benorose/XunFengzhandui/docs/机械组/README.md

# 迅风战队_机械组学习历程

机械组的核心任务是负责一辆小车从建模、打印到装配的全流程工作，确保每个环节衔接顺畅，最终实现小车的完整功能。

## 一、培训学习阶段

### （一）9月27日：机械组第一次通识培训

本次培训围绕小车的组成及相关核心概念展开，具体学习内容如下：

#### 1. 车的组成（地面车型）

| 车型 | 组成部分 | 具体说明 |
| --- | --- | --- |
| 步兵、英雄 | 底盘 | 包含麦轮、舵机、全向轮，是小车移动的基础部件 |
| | 供弹系统 | 需减小云台惯量，并与底盘形成耦合，保障供弹稳定性 |
| | 云台 | 发射系统有两种选择：气动发射系统、摩擦轮发射系统 |
| 工程 | 机械臂 | 由大臂、scara（选择性装配关节机械臂）、副手三部分构成，用于完成特定作业任务 |
| | 底盘 | - |
| | 机架 | 采用铝合金或碳板拼接而成，作用类似“骨头”，为各模块提供稳定支撑 |

#### 2. 核心力学概念

- **强度（屈服强度）**：指材料抵抗塑性形变与断裂的能力，具体是指材料发生明显塑性形变时所对应的应力值。
- **刚度**：材料抵抗弹性形变的能力，刚度越高，材料在受力时越不容易发生弹性变形。
- **拖裂**：一种特殊的断裂形式，材料在没有发生塑性形变的情况下直接断裂。
- **抗拉强度**：材料在被拉断前所能承受的最大应力值，是衡量材料抵抗拉伸破坏能力的重要指标。
- **应力**：单位面积上所承受的压力，是表征材料受力状态的关键参数。
  - **正应力**：方向垂直于材料截面的应力。
  - **切应力**：方向平行于材料截面的应力。
- **应变**：描述物体受力后变形程度的物理量，反映了材料形变的大小。

#### 3. 标准件

重点学习了紧固件类标准件，包括螺丝、螺母、铆钉、垫片，这些零件是小车装配过程中用于连接固定各部件的关键元件。

#### 4. 过往项目参考

- 2025年：无人机云台设计、英雄六摩擦云台设计、英雄中心供弹部分研发
- 2026年：大臂工程模块研发（追赶项目）
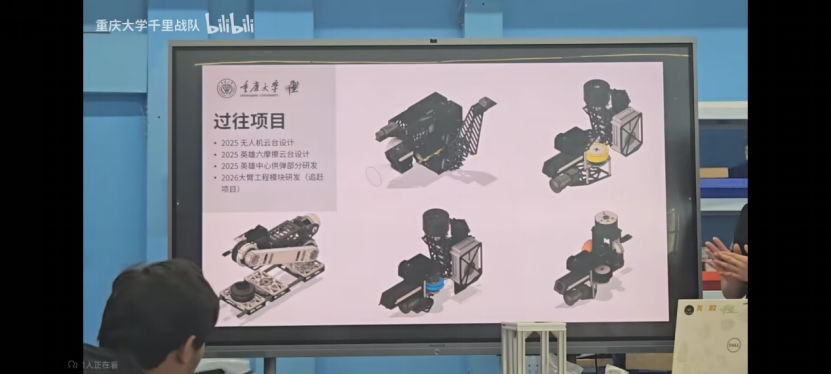
[picture p1: docs/机械组/README.assets/image-20251026011003347.png]
- 

### （二）10月1日 - 10月8日：线上软件学习

自主学习B站Fusion 360基础建模教程，掌握软件基本操作，为后续小车建模工作打下基础。

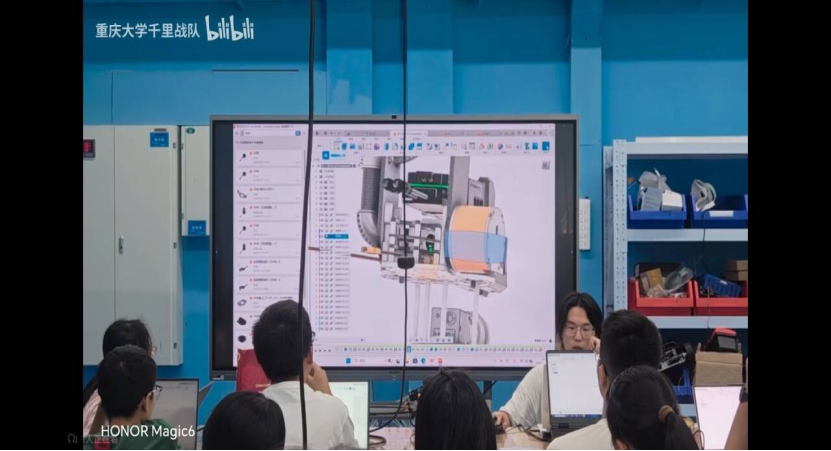
[picture p2: docs/机械组/README.assets/image-20251026011023373.png]


### （三）10月12日：机械组第二次Fusion 360使用教学培训

#### 1. 核心建模流程

1. 选取合适的平面作为草图绘制基准面；
2. 在选定平面上绘制零件的二维草图；
3. 基于二维草图通过拉伸、旋转等操作生成三维实体（特征）。

#### 2. 关键技能学习

学习零件之间的装配与约束方法，掌握如何通过添加约束（如重合、平行、垂直等）确保零件在装配体中位置准确、运动协调。

#### 3. 实践操作
跟随教学视频完成麦克纳姆轮（麦轮）的建模，建模涉及的零件及结构如下：
- 基础部件：支持架（2个）、中轴（1个）
- 功能部件：滚轮（8个，分别为滚轮1 - 8）
- 紧固件：长螺丝（8个，分别为长螺丝1 - 8）、防松螺母（5个，分别为防松螺母1 - 5）

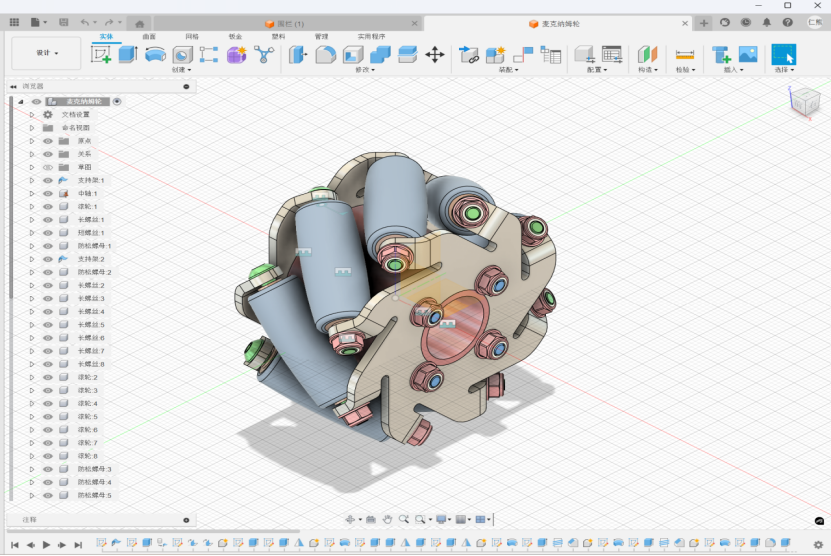
[picture p3: docs/机械组/README.assets/image-20251026011112353.png]


## 二、设计研发阶段

### （一）10月9日：确定小车设计方案
队伍初步明确小车设计方向，采用滚筒作为小球收集装置，通过滚筒的自动运转实现小球的高效收集。

### （二）10月15日 - 10月22日：零件建模与问题解决

#### 1. 舵机与底板连接问题解决
- **问题**：在建模过程中，遇到舵机与底板之间连接方式不明确的问题，需设计专用零件实现两者的固定约束。
- **解决方法**：设计“舵机固定”零件，该零件可有效衔接舵机与底板，确保两者相对位置固定，满足使用需求。
- **最终效果**：舵机与底板通过“舵机固定”零件实现稳定连接，具体效果如图所示：
舵机固定零件连接效果

#### 2. 滚筒拆分建模
为简化建模流程、提高模型精度，将滚筒设计拆分为四个部分分别建模，各部分具体信息如下：
- **连接杆**：滚筒的连接支撑部件，模型如图所示：
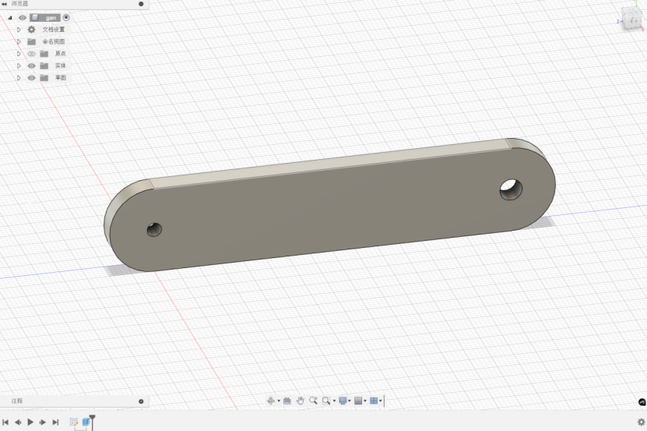
[picture p4: docs/机械组/README.assets/image-20251026011256394.png]
  

- **轴心杆**：滚筒的核心旋转部件，模型如图所示：

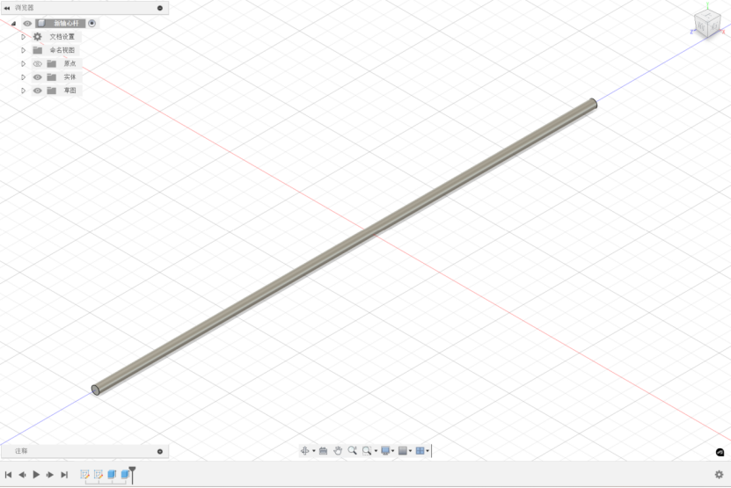
[picture p5: docs/机械组/README.assets/image-20251026011329607.png]
- 

- **圆盘**：滚筒的辅助结构部件，模型如图所示：

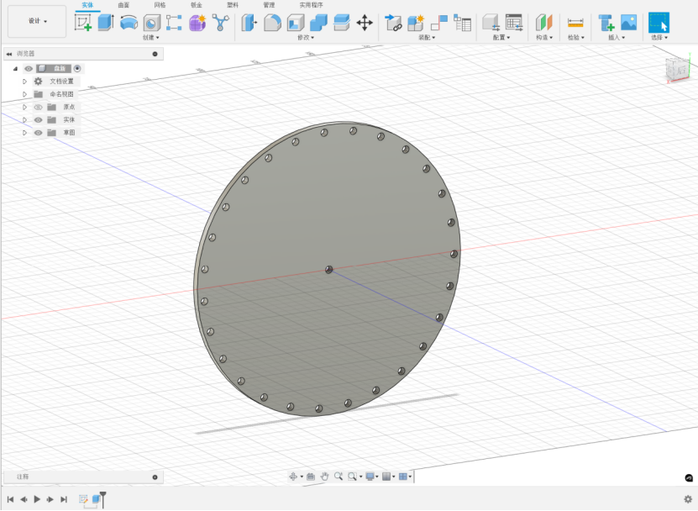
[picture p6: docs/机械组/README.assets/image-20251026011349457.png]
- 

- **固定盖**：用于固定滚筒各部件的零件，模型如图所示：
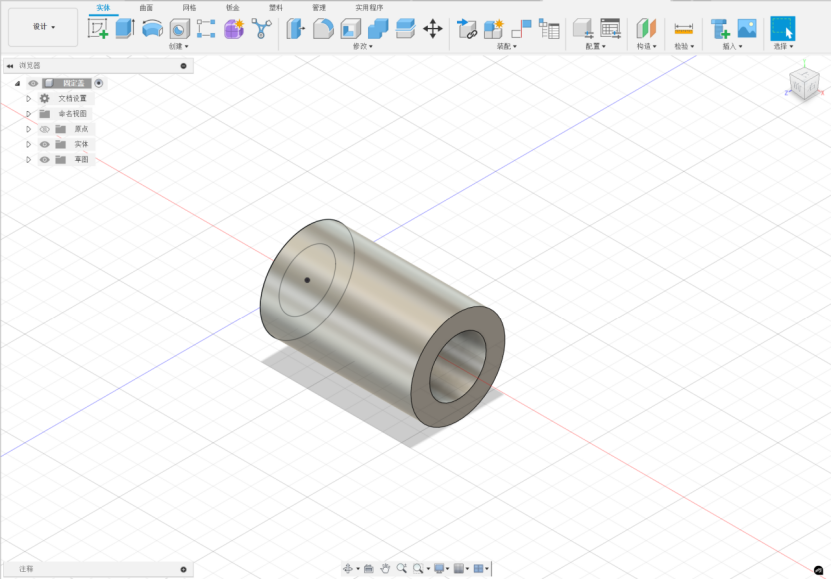
[picture p7: docs/机械组/README.assets/image-20251026011402899.png]
  

- **完整效果：**

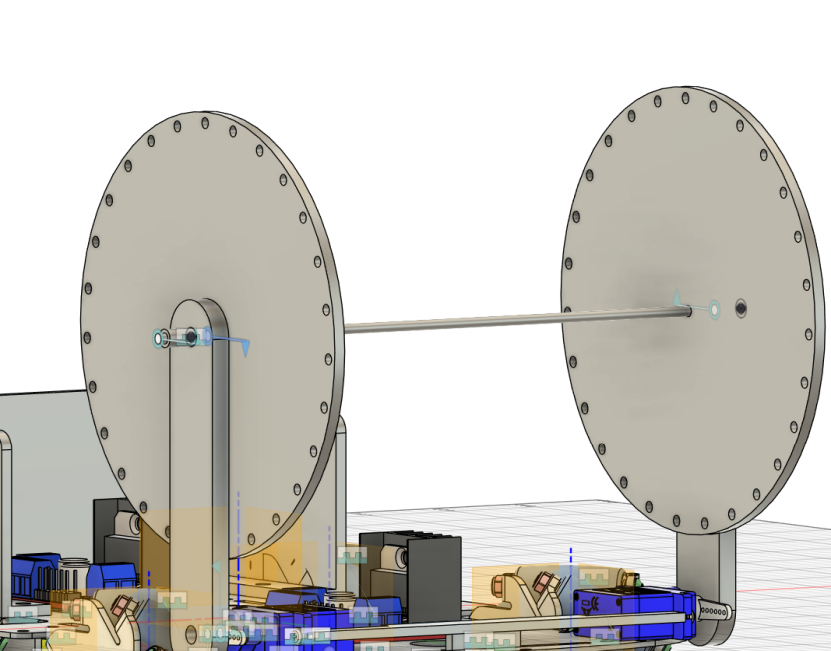
[picture p8: docs/机械组/README.assets/image-20251026011540131.png]
  

#### 3. 围栏设计
为实现小球的有效收集，设计围栏结构，用于引导和限制小球运动轨迹，确保小球能顺利进入滚筒收集范围，围栏模型如图所示：
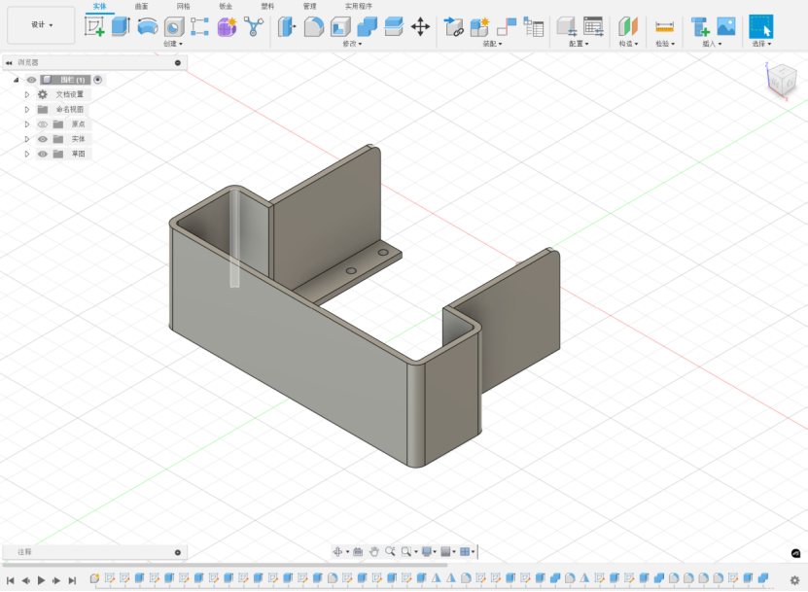
[picture p9: docs/机械组/README.assets/image-20251026011450980.png]


#### 4. 整车装配建模
完成各零件建模后，进行小车整体的连接装配建模，最终得到小车完整装配模型，模型包含金属底盘、黄马达、L298N电机驱动、麦克纳姆轮、舵机、舵机固定件、滚筒各部件、围栏等所有核心部件，具体如图所示：
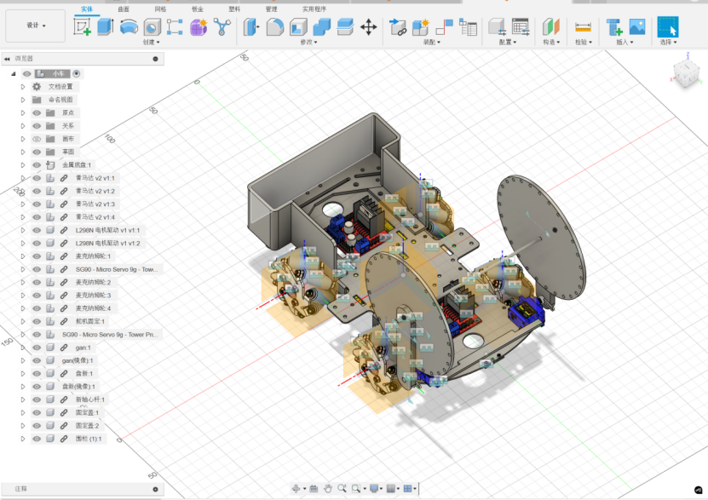
[picture p10: docs/机械组/README.assets/image-20251026011506100.png]


通过联接检测验证，该装配模型能够实现各部件的正常转动，且满足刚性约束要求，符合设计预期。

## 三、实物制作阶段

### （一）10月24日：3D打印培训与零件打印
参与线下3D打印培训，掌握3D打印的操作流程、参数设置等关键技能，随后对已完成建模的小车零件进行3D打印，为后续小车拼装做准备，3D打印相关场景如图所示：
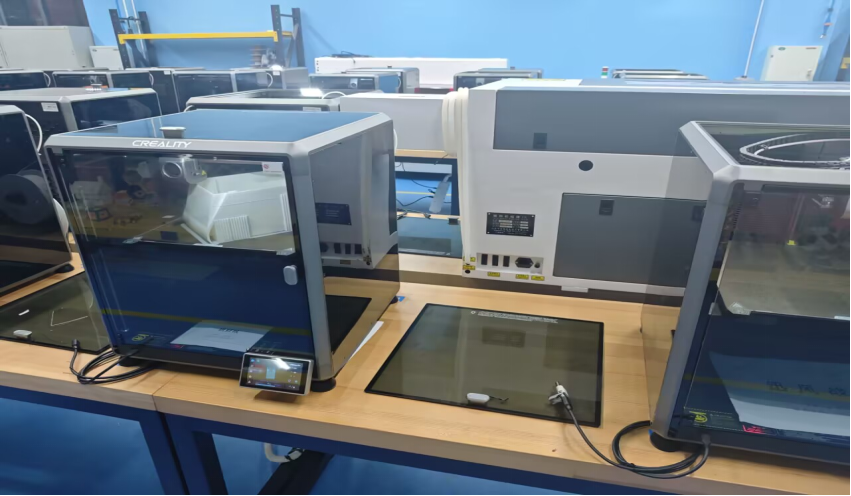
[picture p11: docs/机械组/README.assets/image-20251026011422784.png]


### （二）10月25日：小车拼装
将3D打印完成的零件与采购的标准件（如螺丝、螺母等）进行组装，完成小车的实物制作，标志着机械组从建模到装配的全流程任务初步完成。
