benorose/XunFengzhandui/docs/硬件组/README.md

# 嘉立创EDA PCB制作学习记录

> 我的任务是使用嘉立创EDA完成PCB设计、打样与焊接。以下是我学习与实践过程的具体记录 

## 1. 软件准备与项目初始化

安装了嘉立创EDA专业版并登录账号。创建新项目，并根据电控组的连线及PWM信号控制建立了原理图文件和PCB文件。 

## 2. 原理图设计

从嘉立创的在线元件库中查找并放置所需元件。使用导线工具和网络标签连接电路。



## 3. PCB布局

通过"设计 -> 同步原理图"将元件和网络导入PCB。根据PCB的导线进行元件放置，尽量少有导线交叉。 

## 4. PCB布线

优先布置了电源和地线。随后手动连接信号线，并尽量保持走线简短。布线完成后，在顶层和底层进行了GND敷铜。最后运行了DRC（设计规则检查），确保无误报。

![IMG_256]()

## 5. 生成生产文件

通过"文件 -> 导出 -> Gerber"生成了Gerber文件和NC Drill文件。将这些文件打包成一个ZIP压缩包。同时导出了BOM（物料清单）和坐标文件。

## 6. 提交打样

登录嘉立创下单平台，上传文件。核对系统生成的预览图，确认与设计一致。设置打样参数，确认价格并完成了支付。

![img]()

## 7. 后续工作

收到PCB后，根据BOM表采购元件，并准备焊接工具进行焊接。焊接完成后，使用万用表进行连通性测试，并进行上电功能验证。
