benorose/XunFengzhandui/docs/机械组/图片/固定盖.png

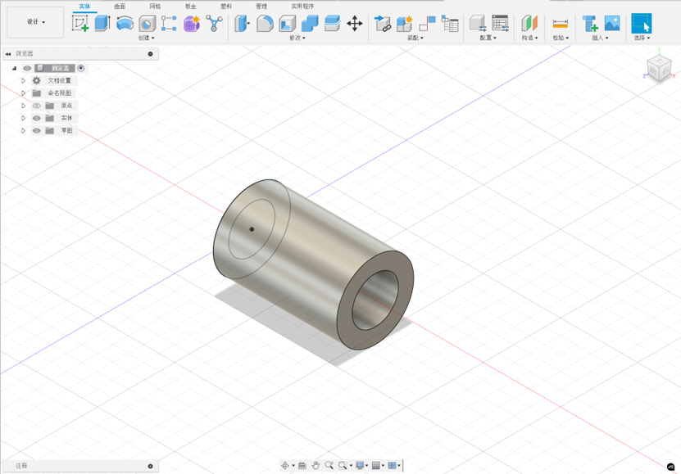
docs/机械组/图片/固定盖.png
