benorose/XunFengzhandui/docs/机械组/图片/圆盘.png

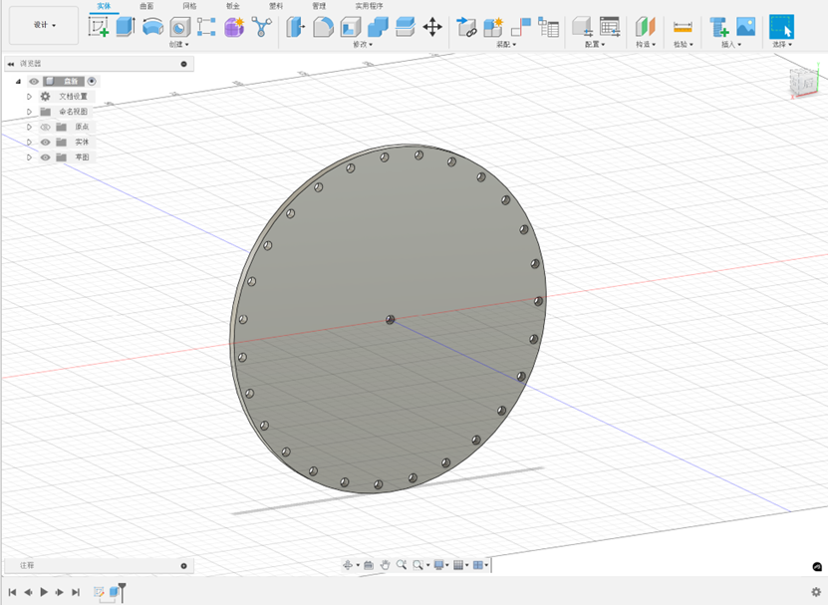
docs/机械组/图片/圆盘.png
