benorose/XunFengzhandui/docs/机械组/图片/舵机固定装置.png

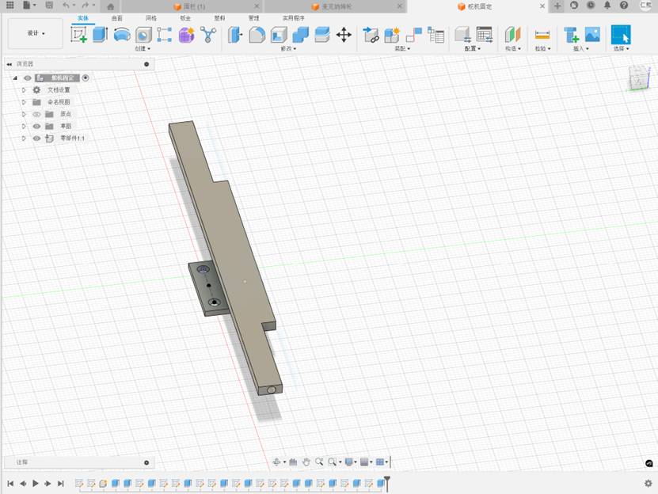
docs/机械组/图片/舵机固定装置.png
