benorose/XunFengzhandui/docs/机械组/图片/舵机连接效果.png

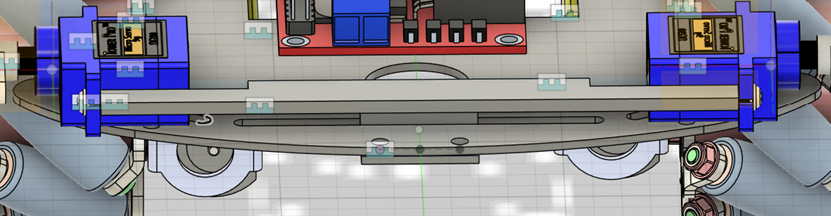
docs/机械组/图片/舵机连接效果.png
