benorose/XunFengzhandui/docs/机械组/图片/连接杆.png

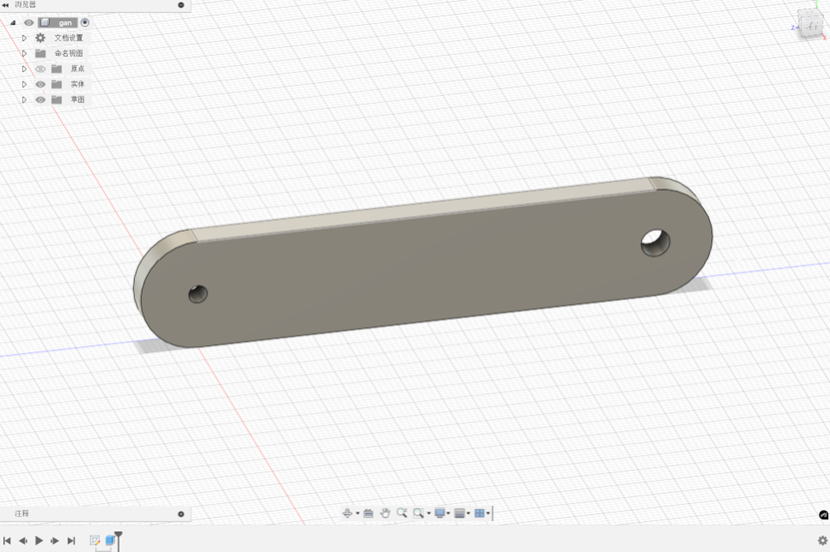
docs/机械组/图片/连接杆.png
