benorose/XunFengzhandui/docs/硬件组/README.assets/image-20251026012540424.png

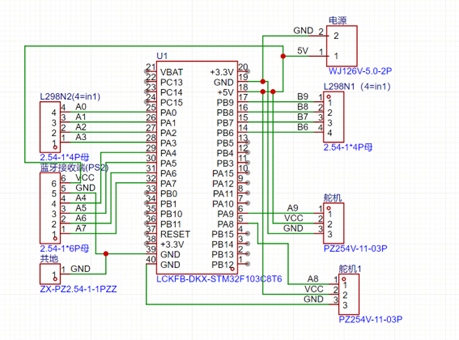
docs/硬件组/README.assets/image-20251026012540424.png
