benorose/XunFengzhandui/(list of files, cad)

Other CAD files:
docs/机械组/建模文件/gan.f3d
docs/机械组/建模文件/围栏 (1).f3d
docs/机械组/建模文件/固定盖.f3d
docs/机械组/建模文件/新轴心杆.f3d
docs/机械组/建模文件/盘新.f3d
docs/机械组/建模文件/舵机固定.f3d
docs/机械组/建模文件/麦克纳姆轮.f3d
