benorose/XunFengzhandui/docs/电控组/STM32_programme/Task_01/Core/Src/main.c

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
/* Includes ------------------------------------------------------------------*/
#include "main.h"
#include "tim.h"
#include "gpio.h"

/* USER CODE BEGIN Includes */
#include "ax_ps2.hpp"
#include"motor_control.h"
/* USER CODE END Includes */

/* USER CODE BEGIN PD */
#define max_pulse 3600
#define full_dir 255
#define zore_fir 0
/* USER CODE END PD */


void SystemClock_Config(void);
/* USER CODE BEGIN 0 */
JOYSTICK_TypeDef ps2;
/* USER CODE END 0 */

/**
  * @brief  The application entry point.
  * @retval int
  */
int main(void)
{

  /* MCU Configuration--------------------------------------------------------*/

  /* Reset of all peripherals, Initializes the Flash interface and the Systick. */
  HAL_Init();

  /* USER CODE BEGIN Init */
  AX_PS2_Init();
  /* USER CODE END Init */

  /* Configure the system clock */
  SystemClock_Config();

  /* Initialize all configured peripherals */
  MX_GPIO_Init();
  MX_TIM4_Init();
  MX_TIM2_Init();
  MX_TIM1_Init();
  /* USER CODE BEGIN 2 */
  MotorControl_Init();
  int compare_init_1 = 0;
  int compare_init_2 = 2700;
  HAL_GPIO_WritePin(GPIOC, GPIO_PIN_13, GPIO_PIN_RESET);
  /* USER CODE END 2 */

  /* Infinite loop */
  /* USER CODE BEGIN WHILE */
  while (1)
  {
	  AX_PS2_ScanKey(&ps2);

	         // 获取移动方向
	         int index = GetMoveDirection(&ps2);

	         // 根据方向控制电机
	         if(index == -1)
	         {
	             StopAllMotors();
	         }
	         else
	         {
	             SetMotorSpeed(index, compare_init_2, compare_init_1);
	         }

	 HAL_Delay(10);
    /* USER CODE END WHILE */

    /* USER CODE BEGIN 3 */
  }
  /* USER CODE END 3 */
}

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
