benorose/XunFengzhandui/docs/电控组/STM32_programme/Task_01/Core/Inc/main.h

#define B_IN1_Pin GPIO_PIN_0
#define B_IN1_GPIO_Port GPIOA
#define B_IN2_Pin GPIO_PIN_1
#define B_IN2_GPIO_Port GPIOA
#define B_IN3_Pin GPIO_PIN_2
#define B_IN3_GPIO_Port GPIOA
#define B_IN4_Pin GPIO_PIN_3
#define B_IN4_GPIO_Port GPIOA
#define DAT_Pin GPIO_PIN_4
#define DAT_GPIO_Port GPIOA
#define CMD_Pin GPIO_PIN_5
#define CMD_GPIO_Port GPIOA
#define CS_Pin GPIO_PIN_6
#define CS_GPIO_Port GPIOA
#define CLK_Pin GPIO_PIN_7
#define CLK_GPIO_Port GPIOA
#define Servo_2_Pin GPIO_PIN_8
#define Servo_2_GPIO_Port GPIOA
#define Servo_1_Pin GPIO_PIN_9
#define Servo_1_GPIO_Port GPIOA
#define F_IN1_Pin GPIO_PIN_6
#define F_IN1_GPIO_Port GPIOB
#define F_IN2_Pin GPIO_PIN_7
#define F_IN2_GPIO_Port GPIOB
#define F_IN3_Pin GPIO_PIN_8
#define F_IN3_GPIO_Port GPIOB
#define F_IN4_Pin GPIO_PIN_9
#define F_IN4_GPIO_Port GPIOB
