benorose/XunFengzhandui/(notices)

Notices in the files:
docs/电控组/STM32_programme/Task_01/Core/Src/main.c:
Copyright (c) 2025 STMicroelectronics.
All rights reserved.
This software is licensed under terms that can be found in the LICENSE file
